MakerM0/FreshWatch/hardware/readme.md

# PCB Thickness

0.8mm

## v1.4

- Optimize the PCB routing
