MakerM0/FreshWatch/hardware/v1.4/SCH_v1.4.png

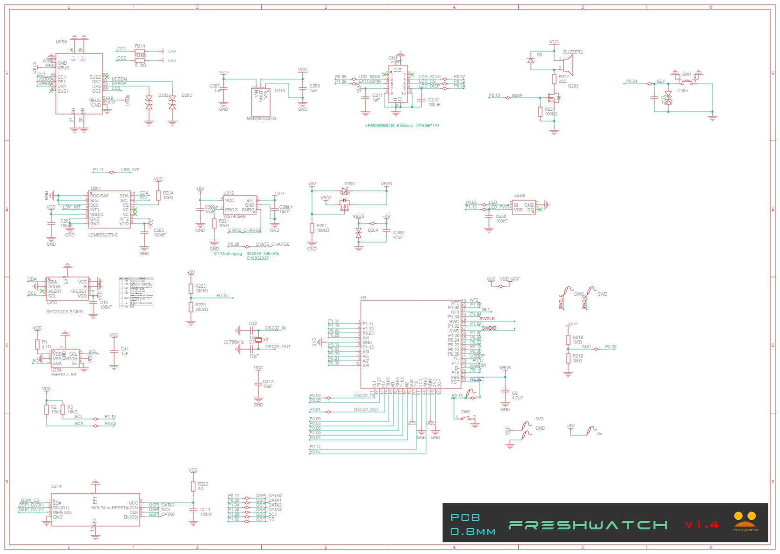
hardware/v1.4/SCH_v1.4.png
