MakerM0/FreshWatch/mechanical/preview.png

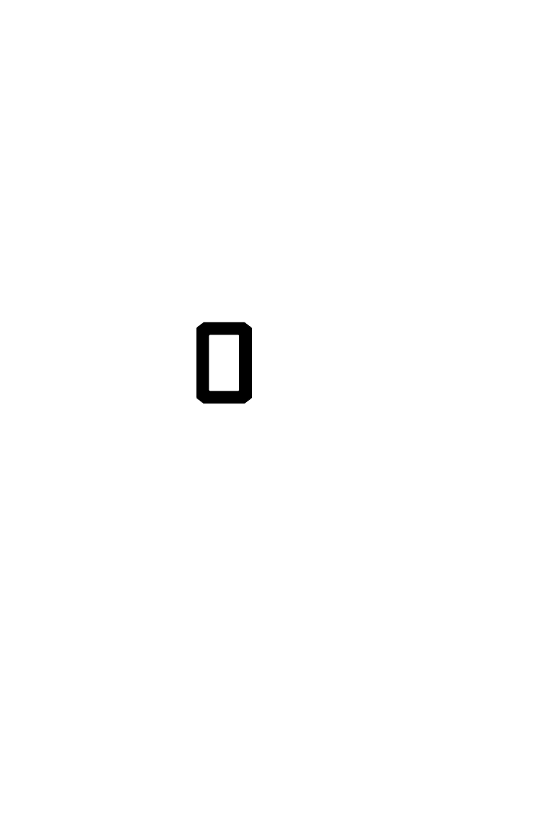
mechanical/preview.png
