MakerM0/FreshWatch/hardware/v1.4/BOM_v1.4.xlsx

Comment | Designator | Footprint | Supplier Part | Quantity | Manufacturer | Manufacturer Part
DET402-G-1 | BUZZER2 | BUZ-SMD_L4.0-W3.0-LS4.5-FD | C2911630 | 1 |  | DET402-G-1
12pF | C31,C32 | C0402 | C1547 | 2 | FH(风华) | 0402CG120J500NT
100nF | C40,C202,C203,C208,C210,C213,C214 | C0402 | C1525 | 7 | SAMSUNG(三星) | CL05B104KO5NNNC
1uF | C41,C206,C207,C211 | C0402 | C52923 | 4 | SAMSUNG(三星) | CL05A105KA5NQNC
10uF | C200,C201 | C0603 | C19702 | 2 | SAMSUNG(三星) | CL10A106KP8NNNC
AXE510127D | CN1 | CONN-SMD_AXE510127 | C2924266 | 1 | PANASONIC(松下) | AXE510127D
1N4148WT | D3 | SOD-523_L1.2-W0.8-LS1.6-RD | C232841 | 1 | onsemi(安森美) | 1N4148WT
1N5819WS | D200 | SOD-323_L1.8-W1.3-LS2.5-RD | C191023 | 1 | Hottech(合科泰) | 1N5819WS
PESDNC2FD3V3B | D202,D203,D205 | DFN1006-2L-BI | C492728 | 3 | Prisemi(芯导) | PESDNC2FD3V3B
PESDNC2FD5VB | D204 | DFN1006-2L-BI | C110694 | 1 | Prisemi(芯导) | PESDNC2FD5VB
XL-2020RGBC-WS2812B | LED9 | LED-SMD_4P-L2.0-W2.0-BR-1 | C5349955 | 1 | XINGLIGHT(成兴光) | XL-2020RGBC-WS2812B
WST3401A | Q201 | SOT-23-3_L2.9-W1.6-P1.90-LS2.8-BR | C2758407 | 1 | WINSOK(微硕) | WST3401A
WST3400A | Q203 | SOT-23-3_L2.9-W1.6-P1.90-LS2.8-BR | C2758406 | 1 | WINSOK(微硕) | WST3400A
4.7Ω | R1 | R0402 | C25121 | 1 | UNI-ROYAL(厚声) | 0402WGF470KTCE
10kΩ | R2,R3,R204,R221 | R0402 | C25744 | 4 | UNI-ROYAL(厚声) | 0402WGF1002TCE
100kΩ | R207,R220,R223 | R0402 | C25741 | 3 | UNI-ROYAL(厚声) | 0402WGF1003TCE
5.1kΩ | R214,R215 | R0402 | C25905 | 2 | UNI-ROYAL(厚声) | 0402WGF5101TCE
1MΩ | R218,R219 | R0402 | C26083 | 2 | UNI-ROYAL(厚声) | 0402WGF1004TCE
0Ω | R222 | R0402 | C17168 | 1 | UNI-ROYAL(厚声) | 0402WGF0000TCE
200kΩ | R226 | R0402 | C25764 | 1 | UNI-ROYAL(厚声) | 0402WGF2003TCE
22Ω | R227 | R0402 | C25092 | 1 | UNI-ROYAL(厚声) | 0402WGF220JTCE
TS24CA 250gf 013 | SW1 | SW-SMD_L4.7-W3.5-P3.35-EH | C5373430 | 1 | SHOU HAN(首韩) | TS24CA 250gf 013
TS-1185-C-A-B-A | SW2 | SW-SMD_L4.0-W2.9-LS5.0 | C561519 | 1 | XKB Connectivity(中国星坤) | TS-1185-C-A-B-A
E73-2G4M08S1C | U3 | WIRELM-SMD_E73-2G4M08S1C | C356849 | 1 | EBYTE(亿佰特) | E73-2G4M08S1C
LSM6DS3TR-C | U201 | LGA-14_L3.0-W2.5-P0.50-TL | C967633 | 1 | ST(意法半导体) | LSM6DS3TR-C
SGP40-D-R4 | U209 | DFN-6_L2.4-W2.4-P0.80-TL-EP | C2874215 | 1 | Sensirion(瑞士盛思锐) | SGP40-D-R4
SHT30-DIS-B10KS | U210 | DFN-8_L2.5-W2.5-P0.50-BL-EP | C2687423 | 1 | Sensirion(瑞士盛思锐) | SHT30-DIS-B10KS
WST4054A | U212 | SOT-23-5_L3.0-W1.6-P0.95-LS2.8-BR | C2985891 | 1 | WINSOK(微硕) | WST4054A
ME6206A33XG | U213 | SOT-23-3_L2.9-W1.6-P1.90-LS2.8-BR | C161345 | 1 | MICRONE(南京微盟) | ME6206A33XG
W25Q32JVUUIQ | U214 | USON-8_L4.0-W3.0-P0.80-BL_WINBOND_UU | C2999380 | 1 | WINBOND(华邦) | W25Q32JVUUIQ
HX TYPE-C 16P CB0.8 | USB5 | USB-C-SMD_HX-TYPE-C-16P-CB0.8 | C5178542 | 1 | hanxia(韩下) | HX TYPE-C 16P CB0.8
32.768kHz | X3 | CRYSTAL-SMD_2P-L2.0-W1.2 | C7500573 | 1 | YXC(扬兴晶振) | XKHEL89CGI-112YLC-32.768K
